marcokvendramin/Alinhamento_Automatico_Sistema_FSO/schematics/Esquematico_2_Placas.jpeg

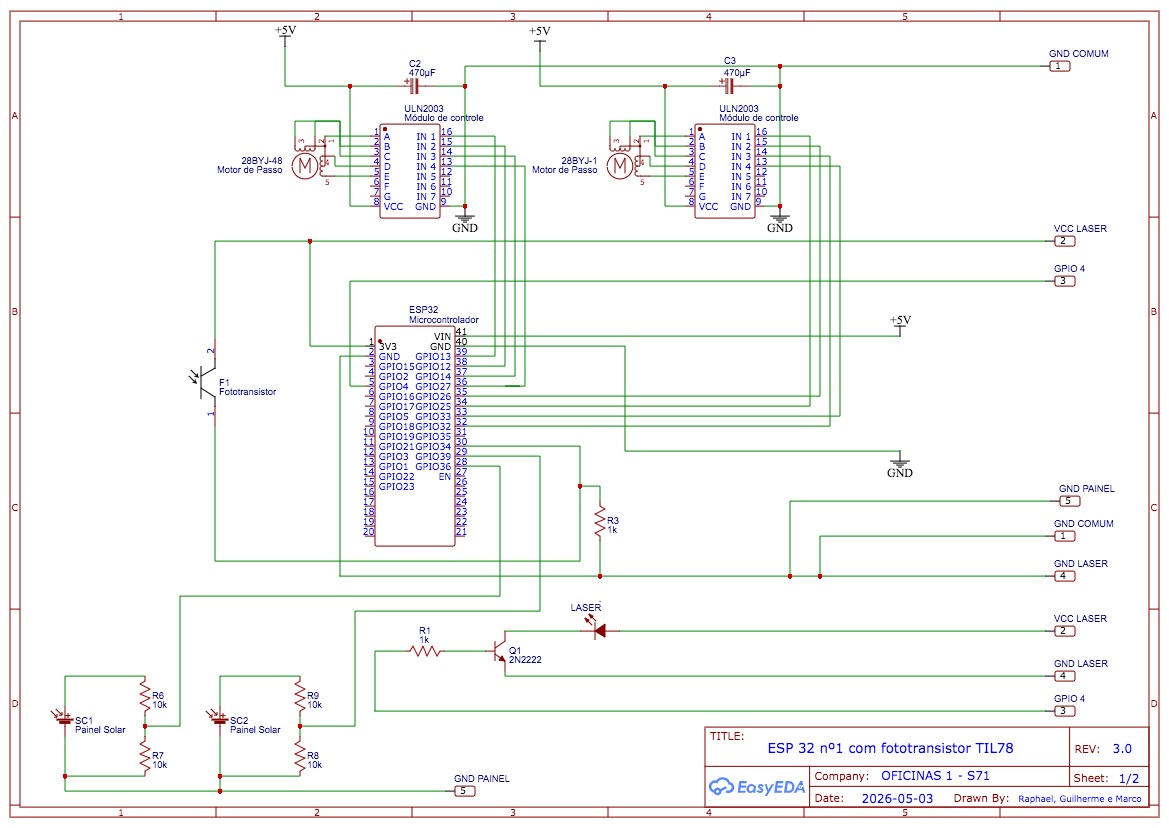
schematics/Esquematico_2_Placas.jpeg
