marcokvendramin/Alinhamento_Automatico_Sistema_FSO/schematics/Esquematico_Sem_Placa.jpeg

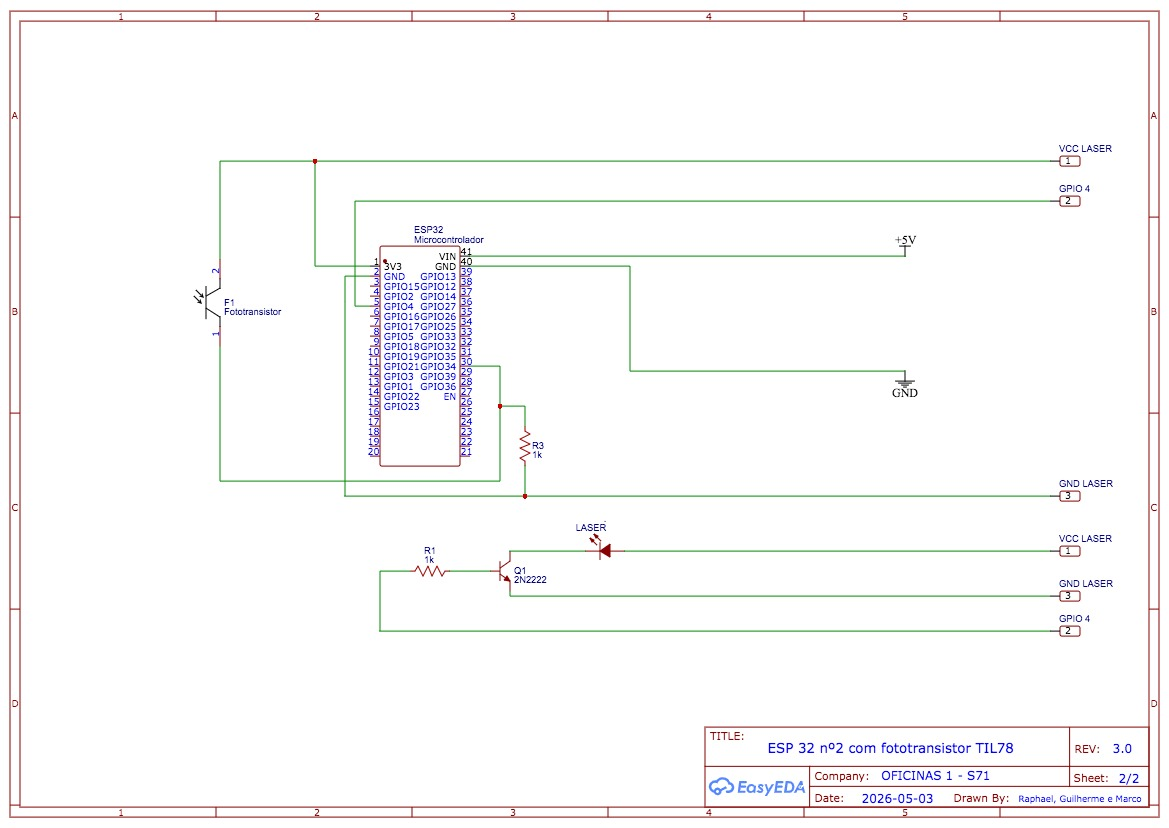
schematics/Esquematico_Sem_Placa.jpeg
