marcokvendramin/Alinhamento_Automatico_Sistema_FSO/aux/imagens_teste_envio/1KB.jpg

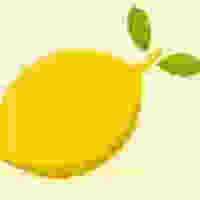
aux/imagens_teste_envio/1KB.jpg
