marcokvendramin/Alinhamento_Automatico_Sistema_FSO/aux/imagens_teste_envio/1KB.png

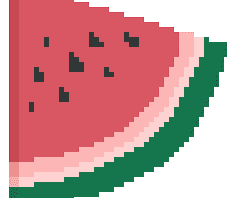
aux/imagens_teste_envio/1KB.png
