marcokvendramin/Alinhamento_Automatico_Sistema_FSO/aux/imagens_teste_envio/2KB.jpg

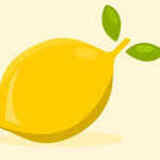
aux/imagens_teste_envio/2KB.jpg
