marcokvendramin/Alinhamento_Automatico_Sistema_FSO/aux/imagens_teste_envio/600bytes.jpg

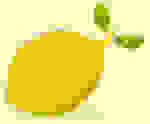
aux/imagens_teste_envio/600bytes.jpg
