marcokvendramin/Alinhamento_Automatico_Sistema_FSO/(commit log)

2026-07-30 Add HTML pages for web interface
    This commit adds multiple HTML pages for a web interface, including pages for data sending, reception, calibration, and alignment. The pages contain styling and JavaScript for functionality.
2026-07-30 Clean up code by removing commented sections
    Removed commented sections for motor pins, axis inversion, speed and acceleration configuration, manual control, functions, setup, and loop.
